kooi/schaakrobot-pws/README.md

# Schaakrobot

Hoe werk ik?

## TODO
 - [x] flask server die zetten aan arduino doorgeeft
 - [x] template voor schaakbord
 - [x] javascript die zetten klaarzet
 - [ ] javascript voor elk vakje -> IJsbrand
 - [x] kaas-button moet werken (zet-endpoint moet x1 etc. uit de locatie halen) -> Mark
 - [ ] arduino feedback -> IJsbrand
 - [x] vanuit succes in zet -> redirect naar endpoint / -> Mark
 - [ ] visuele feedback (zet moet dan een lijst aan gemaakte zetten bijhouden en teruggeven aan /) 
 - [ ] en reset implementeren -> Mark
 - [ ] readme opschonen -> IJsbrand
