kooi/schaakrobot-pws/verslag/PWS_code.pdf

Hierbij Mark de link naar mijn code, ik wist niet hoe ik hem anders kon inleveren.

https://create.arduino.cc/editor/ysbrandm/7b3feb4c-c94c-475b-893f-984dea7fc0eb/preview
