kooi/schaakrobot-pws/stl/Koppelstuk-PWS-1.stl

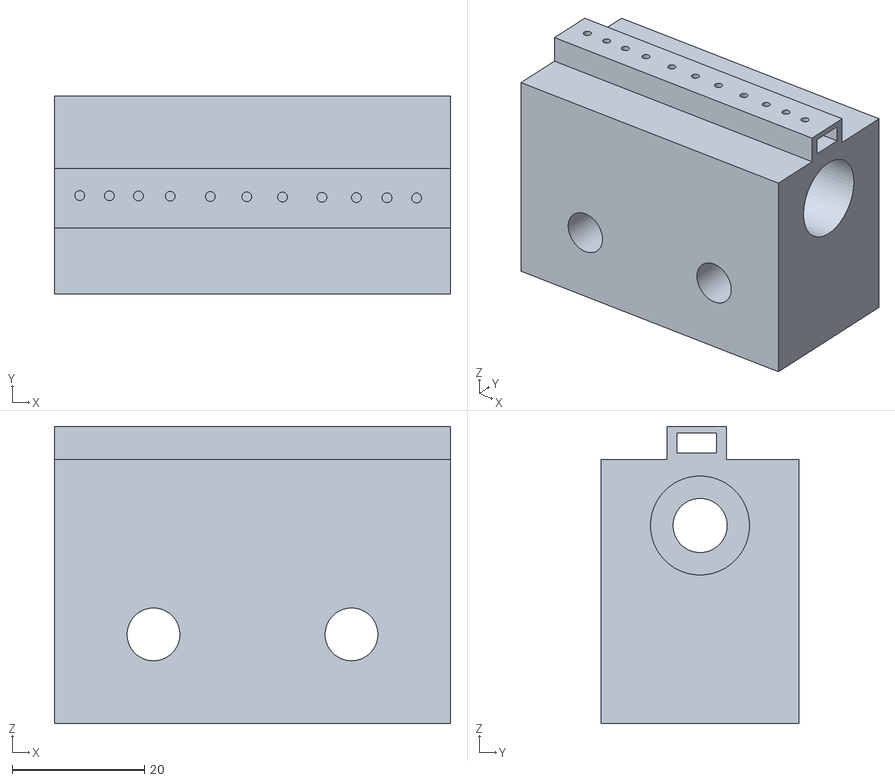
[picture p6: CAD file, 2021-01-21]
stl/Koppelstuk-PWS-1.stl
60.0 x 30.0 x 45.0
