kooi/schaakrobot-pws/stl/Onderdeel_robot_1_keer.stl

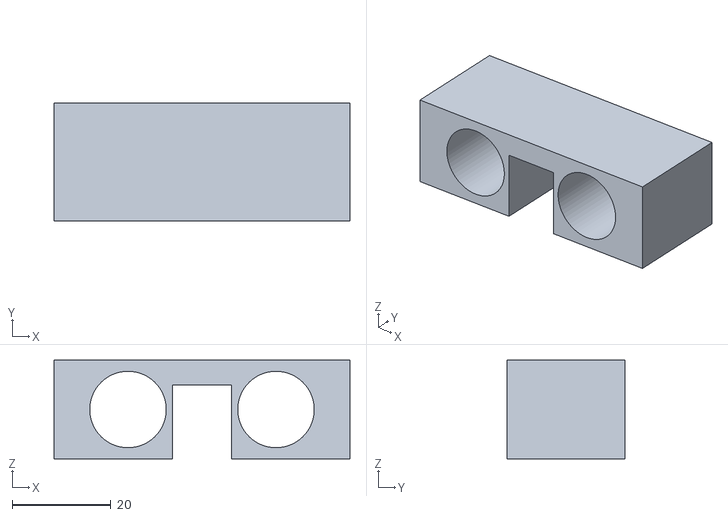
[picture p7: CAD file, 2021-01-21]
stl/Onderdeel_robot_1_keer.stl
60.0 x 24.0 x 20.0
