kooi/schaakrobot-pws/verslag/PWS Log boek - Blad1.pdf

datum | tijdsduur | gedaan | Wie-wat | probleem | oplossing | afspraken
23-05-2020 1.5 uur | Plan voor de robot opgesteld en de eerste Arduino set gekocht IJsbrand | Nog niet duidelijk hoe ik het ga aanpakken en of het een goed Met pws mentor bespreken zodat hij mee kan kijken en zijn mening kan geven Afspraak maken om met Mark te bellen.
27-05-2020 2 uur | Over pws gebeld met Mark Mark en IJsbrandNog steeds een beetje zorgen over of de robot niet te hoog gegrepen is en wat er met mijn cijfer gebeurd als ik het niet afkrijg Duidelijke deelvragen opstellen Goede deelvragen opstellen
13-06-2020 0.5 uur | Het maken van een de eerste tutorial van de Arduino tutorial IJsbrand | - | - | -
29-06-2020 1.5 uur | Beginnen met opstellen van fase 1 werkstuk IJsbrand | Nog niet helemaal zeker of de deelvragen Mark vragen ernaar te kijken Woensdag een presentatie geven
30-06-2020 4 uur | Werken aan fase 1 IJsbrand | Nog steeds een aantal vragen voor Mark Mark vragen blijven stellen Woensdag een presentatie geven
01-07-2020 2,5 uur | Presentatie gegeven en beluisterd van andere mensen Iedereen van Mark's mentorgroep Nog geen feedback gekregen Even wachten op de feedback Donderdag fase 1 inleveren
02-07-2020 3 uur | Het afmaken van fase 1 en het inleveren IJsbrand | - | - | -
totaal | 15 uur
21-08-2020 2 uur | Twee projecten gemaakt IJsbrand | Opstelling zat vaak niet netjes in elkaar Hoeft niet opgelost
23-08-2020 1 uur | 1 project | IJsbrand | Juist geen probleem bied oplossing voor schaakbord Nope
24-08-2020 1 uur | 1 project | IJsbrand | nog steeds geen probleem
24-08-2020 1 uur | afspraak Mark | Mark en IJsbrandAlleen maar oplossingen
26-08-2020 2 uur | 2 projecten | IJsbrand | geen probleem
28-08-2020 2 uur | onderzoek naar materiaal IJsbrand | veel onzekerheid of componenten passen Met Mark maandag praten Maandag Mark zien
29-08-2020 6 uur | 6 projecten gedaanIJsbrand | Niet de juiste liberaries gedownload Nog naar op zoek gaan
30-08-2020 2 uur | Nog meer onderdelen zoeken IJsbrand | Veel verschillende prijzen en levertijden Met Mark over hebben
31-08-2020 2 uur | onderdelen gezocht en ouders uitleggen hoe het werkt, en subsiedie aanvraag bedenken IJsbrand, Pap en Mam Veel onderdelen passen misschien niet bij elkaar Nog meer onderzoek
31-08-2020 1 uur | Met Mark besproken wat bij elkaar past en subsidie aangevraagy IJsbrand, Mark (Annemiek) Nog steeds verschillende odnerdelen die misschien niet bij elkaar passen
01-09-2020 2 uur | Ouders volledig ingelicht en prijzen van materiaal vergeleken IJsbrand en OudersVeel verschillende prijzen en levertijden Nog meer onderzoek
03-09-2020 3 uur | onderdelen bestellen IJsbrand | Niet zeker of alles klopt | -
06-09 1 uur | Uitzoeken hoe een stappenmotor wordt geprogrameerd IJsbrand | Nog niet alles duidelijk maar komt later wel Later nog een uurtje naar kijken
09-09-2020 1 uur | Uitzoeken hoe er moet worden ge-3D print IJsbrand | Software is gedownload alleen moet de software nog begrepen worden Morgen Tutorials opzoeken Kijken of ik iemand kan vinden met een 3D printer die me wil helpen
12-09-2020 2 uur | Stappenmotor aansluiten en laten draaien IJsbrand | Nog niet helemaal netjes laten draaien
13-09-2020 1 uur | Beetje gekloot met de stappenmotor om een goed functionerende moter te krijgen Beter code zoeken-
15-09-2020 1 uur | Nog meer aan de stappenmotor programma's gekloot IJsbrand | Het blijft maar niet goed werken Later nog goed naar kijken
16-09-2020 2 uur | gestart met robot in elkaar zetten IJsbrand | Geen probleem Moet er nog verder aan werken
22-09-2020 3,5 uur | Design gemaakt voor koppelstukken voor de robot en die gemaild IJsbrand | Geen probleem Moet er nog aan werken
25-08-2020 6 uur | programma geschreven en robot in elkaar gezet IJsbrand | Ingewikkelde stappen Bugs fixen
28-09-2020 1 uur | Design tweede koppelstuk IJsbrand | Krijg maar geen contact met de man met de 3D printer Nog een mail sturen

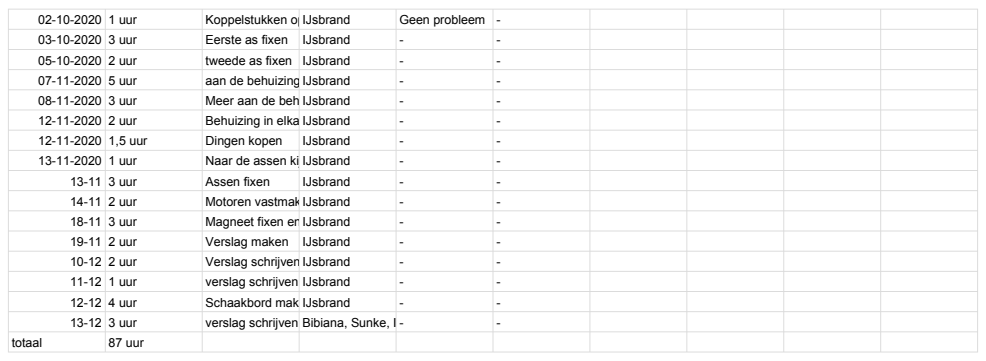
[picture p8: page 2]
02-10-2020 1 uur; Koppelstukken ophalen en afmaken IJsbrand; Geen probleem -; 03-10-2020 3 uur; Eerste as fixen; IJsbrand; 05-10-2020 2 uur; tweede as fixen IJsbrand; 07-11-2020 5 uur; aan de behuizing werken IJsbrand; 08-11-2020 3 uur; Meer aan de behuizing werken IJsbrand; 12-11-2020 2 uur; Behuizing in elkaar zetten IJsbrand; 12-11-2020 1,5 uur; Dingen kopen; 13-11-2020 1 uur; Naar de assen kijken IJsbrand; 13-11 3 uur; Assen fixen; 14-11 2 uur; Motoren vastmakenIJsbrand; 18-11 3 uur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
